afrakatirci/bldc-motor-driver-design/surucugerceklemeresimler/bitirme1.PNG

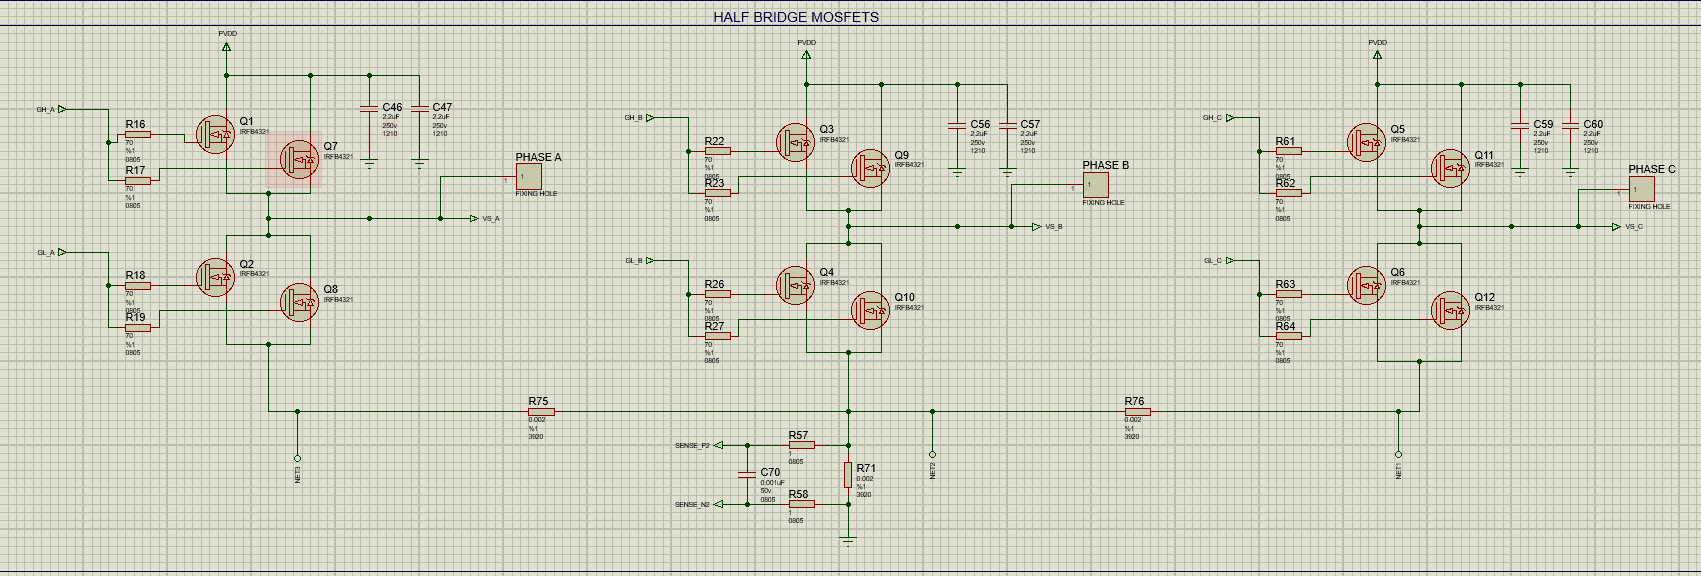
surucugerceklemeresimler/bitirme1.PNG
