afrakatirci/bldc-motor-driver-design/surucugerceklemeresimler/bitirme2.PNG

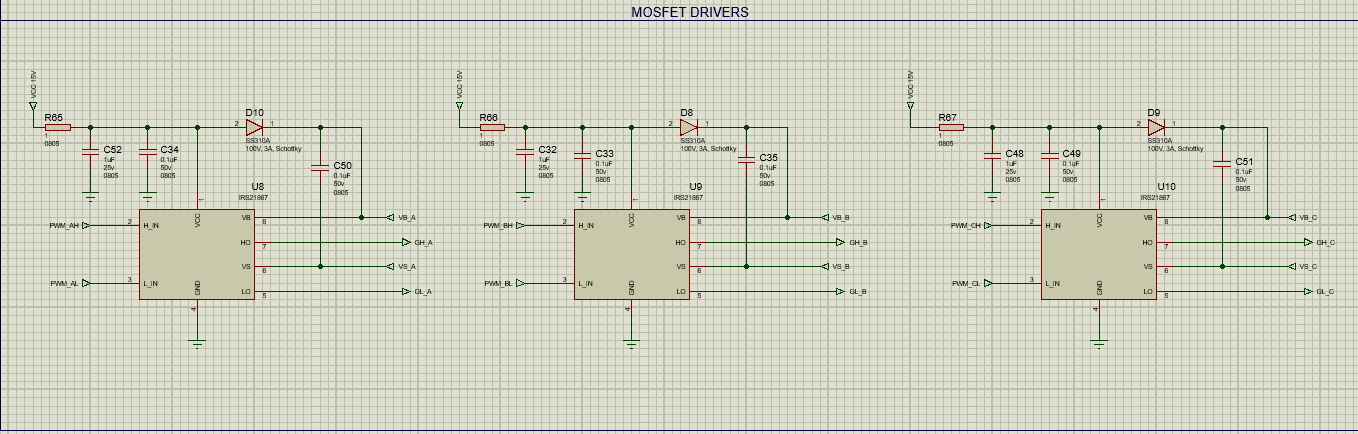
surucugerceklemeresimler/bitirme2.PNG
