afrakatirci/bldc-motor-driver-design/surucugerceklemeresimler/bitirme6.PNG

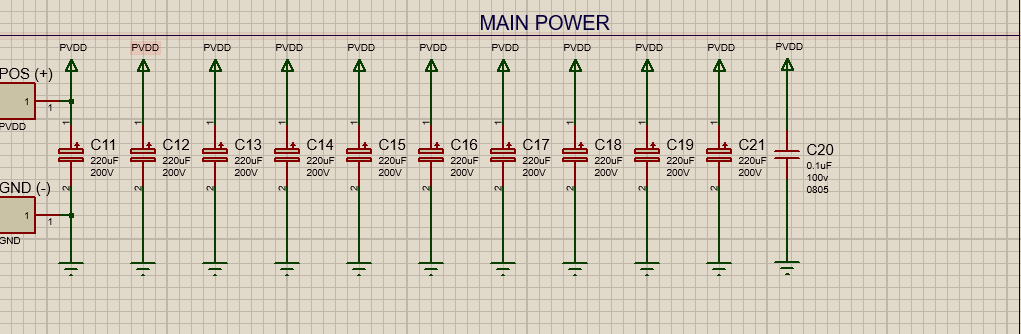
surucugerceklemeresimler/bitirme6.PNG
