afrakatirci/bldc-motor-driver-design/surucugerceklemeresimler/bitirme8ı.PNG

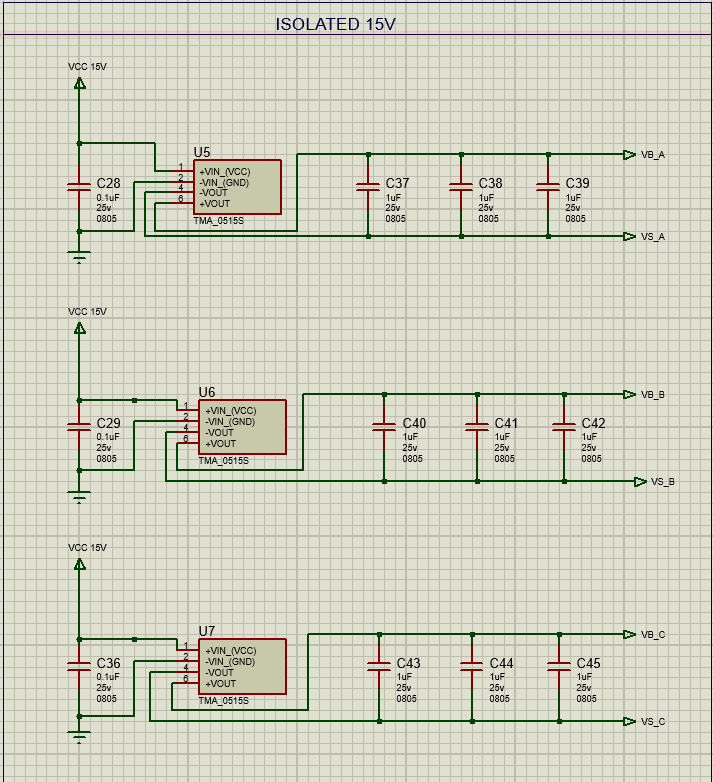
surucugerceklemeresimler/bitirme8ı.PNG
