afrakatirci/bldc-motor-driver-design/surucugerceklemeresimler/bitirme9.PNG

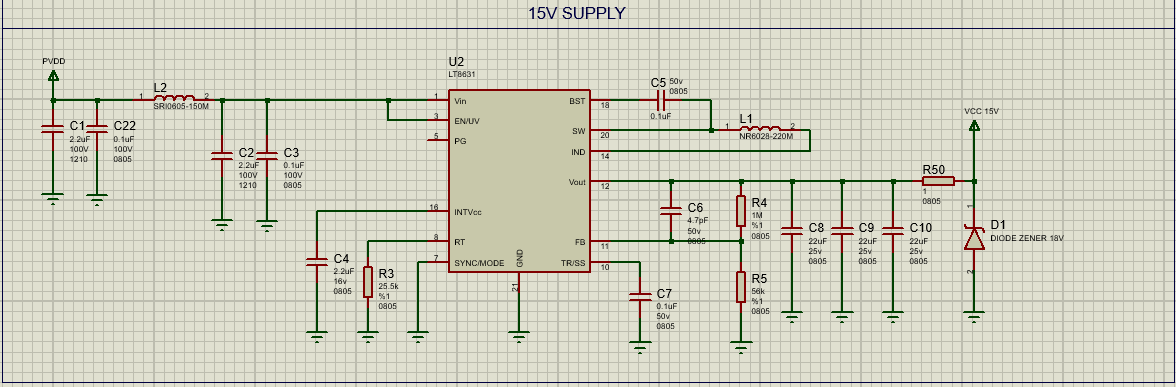
surucugerceklemeresimler/bitirme9.PNG
