afrakatirci/bldc-motor-driver-design/surucugerceklemeresimler/bitirme10.PNG

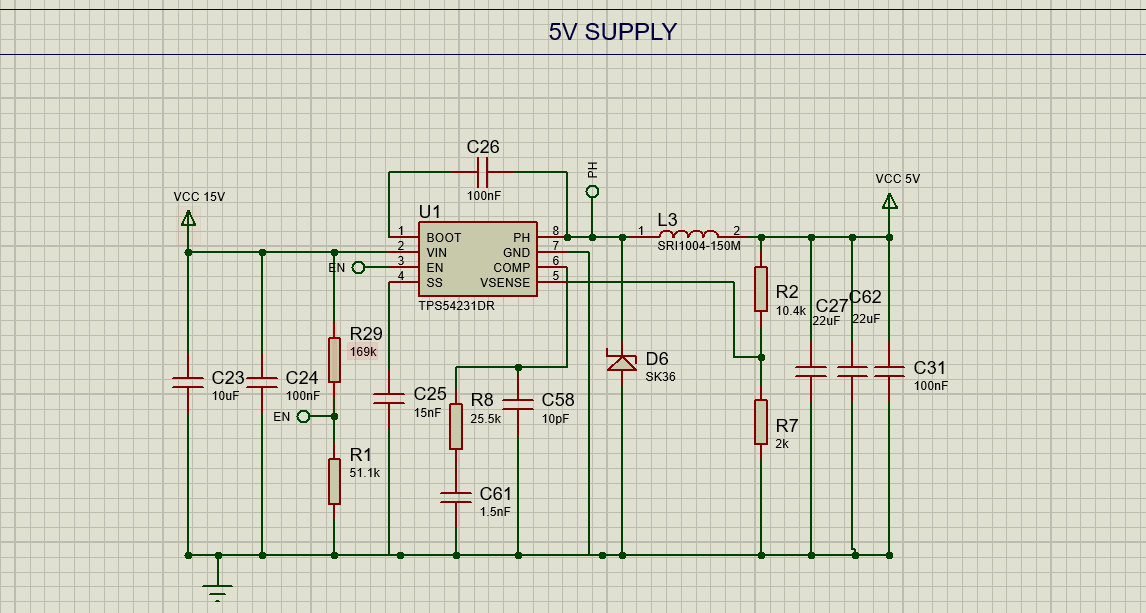
surucugerceklemeresimler/bitirme10.PNG
