afrakatirci/bldc-motor-driver-design/surucugerceklemeresimler/pcblayout.PNG

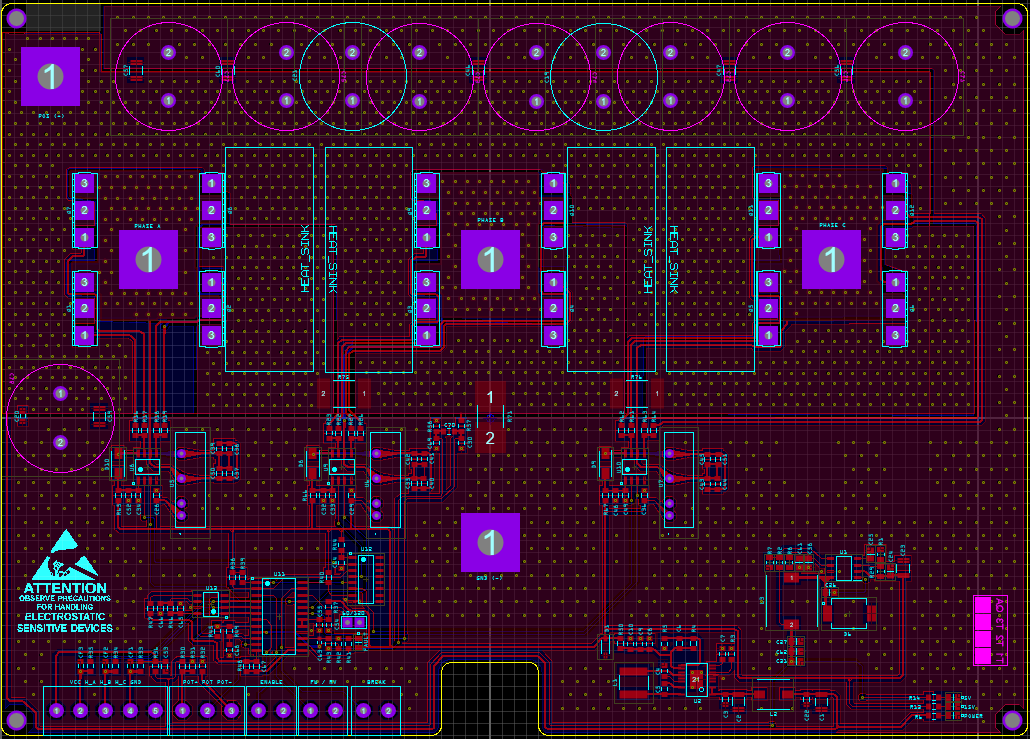
surucugerceklemeresimler/pcblayout.PNG
