afrakatirci/bldc-motor-driver-design/surucugerceklemeresimler/üçboyut.PNG

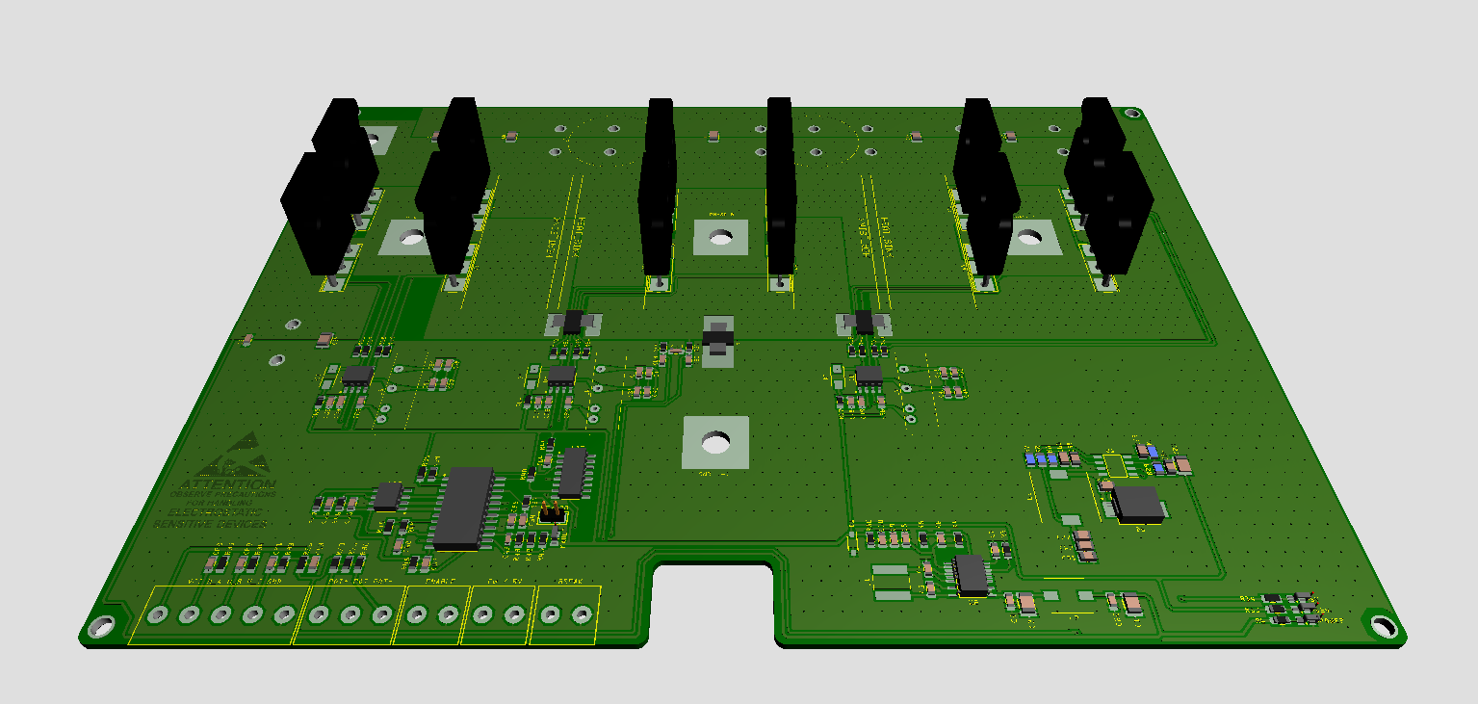
surucugerceklemeresimler/üçboyut.PNG
