afrakatirci/bldc-motor-driver-design/(list of files, drawings)

Other design files:
bldcmotorsurucusımulasyon/48VBLDC.pdsprj
